altnifer/Crocoone/hardware/interface_board/Schematic_interface_board.pdf

Buttons | LCD ST7735S 1.8

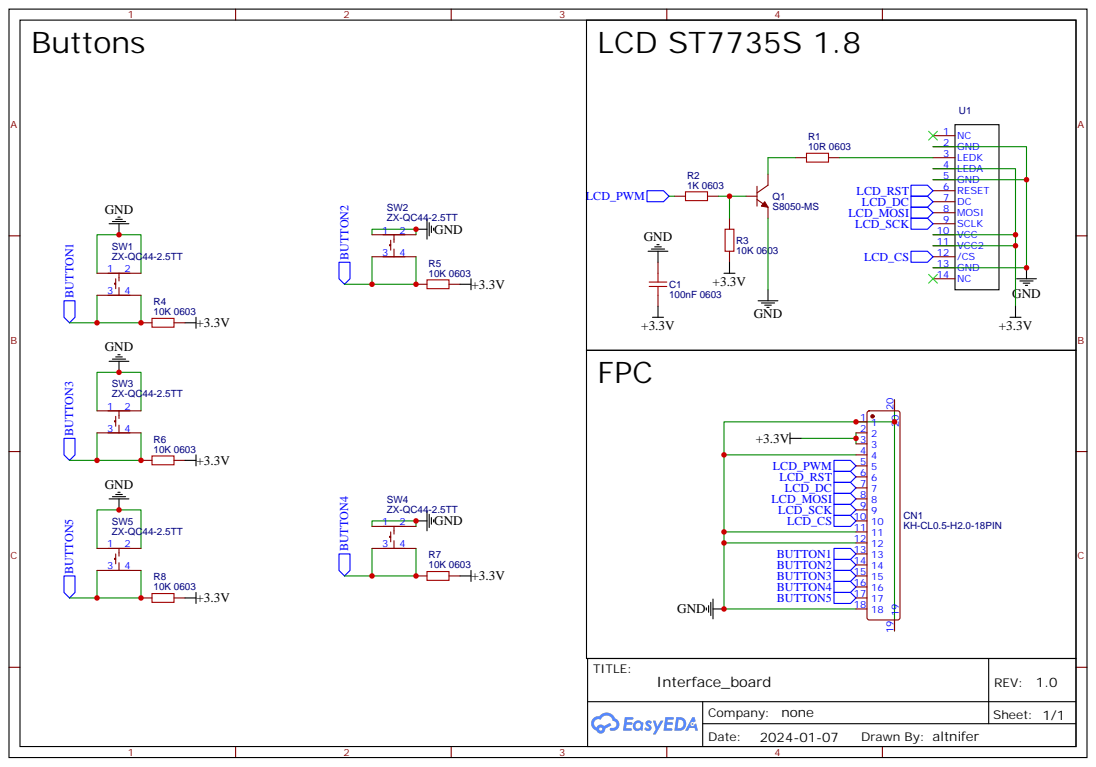
[picture p3: page 1]
