altnifer/Crocoone/hardware/main_board/Schematic_main_board.pdf

# User interface

# Core STM32H750

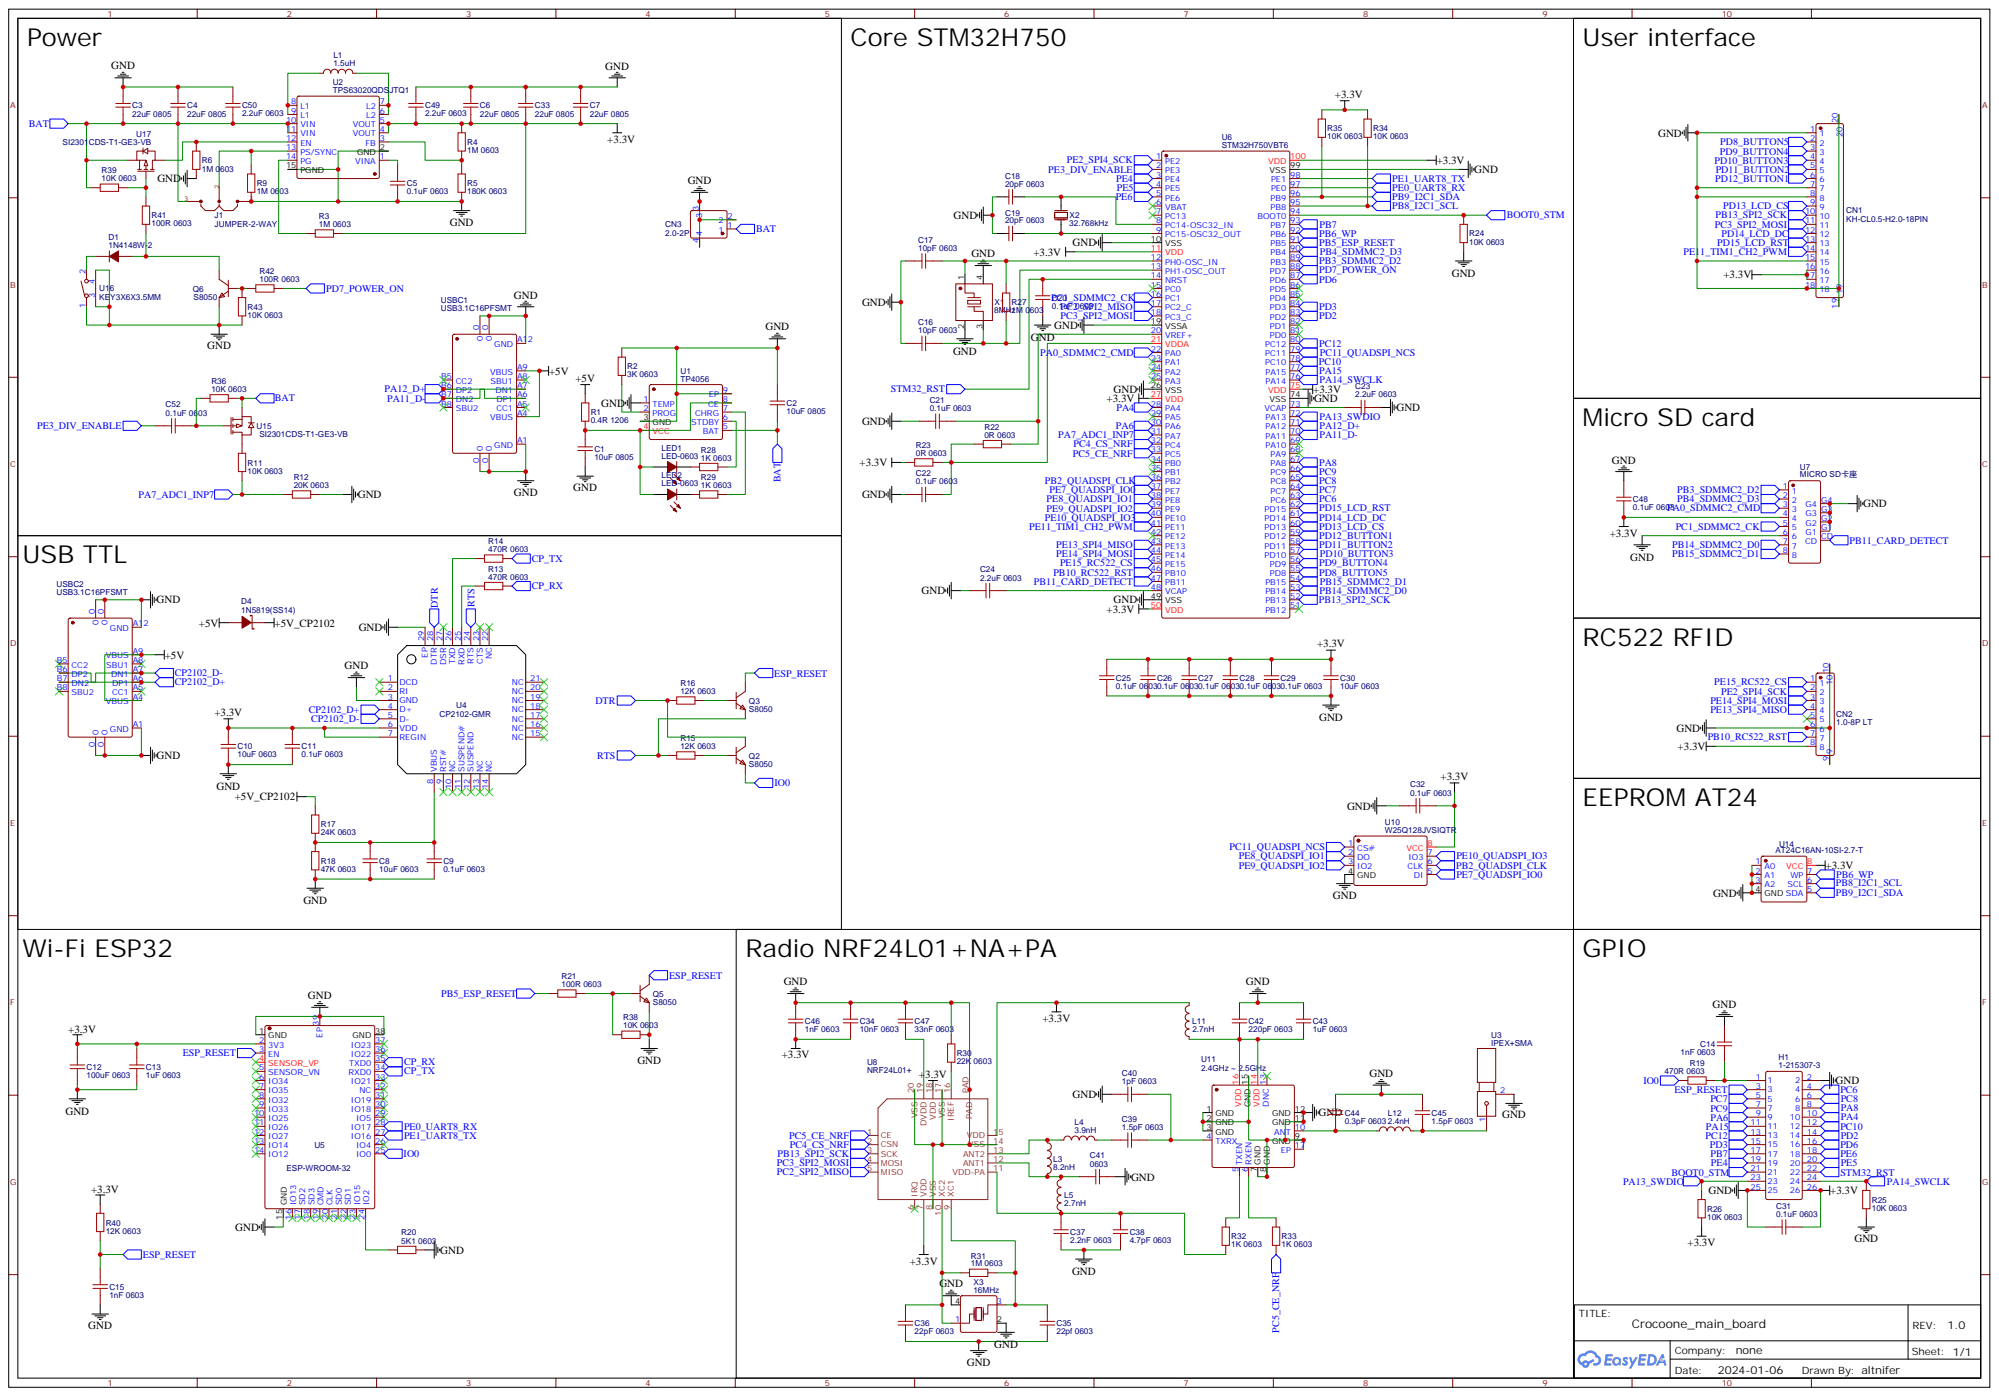
[picture p4: page 1]

NC 22 CTS 23 RTS 24 RXD 25 TXD 26 DSR 27 DTR 28 EP 29

IREF 16 VSS 17 VDD 18 DVDD 19 VSS 20
