altnifer/Crocoone/(list of files, drawings)

Other design files:
hardware/interface_board/PCB_interface_board.json
hardware/interface_board/SCH_interface_board.json
hardware/main_board/PCB_main_board.json
hardware/main_board/SCH_main_board.json
