altnifer/Crocoone/software/STM32/CROCOONE_H743_BOARD/Core/Src/main.c

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
/* Includes ------------------------------------------------------------------*/
#include "main.h"
#include "cmsis_os.h"
#include "fatfs.h"
#include "usb_device.h"

/* USER CODE BEGIN Includes */
#include <stdbool.h>
#include <string.h>

#include "semphr.h"

#include "SETTINGS.h"
#include "GFX_FUNCTIONS.h"
#include "title.h"
#include "button.h"
#include "flash_controller.h"
#include "uart_controller.h"
#include "packet_monitor.h"
#include "ch_analyzer.h"
#include "PMKID_attack.h"
#include "wifi_scan.h"
#include "deauth_attack.h"
#include "beacon_attack.h"
#include "handshake_attack.h"
#include "bad_usb_attack.h"
/* USER CODE END Includes */

/* USER CODE BEGIN PTD */
static const char *MAIN_MENU_SETS[] = {
	"Wi-Fi scan",
	"Ch Analyzer",
	"Pkt Analyzer",
	"PMKID attack",
	"deauth",
	"beacon",
	"handshake",
	"bad usb"
};
#define MAX_MAIN_MENU_SET_COUNT (sizeof(MAIN_MENU_SETS) / sizeof(char *))

SemaphoreHandle_t SPI2_mutex;
/* USER CODE END PTD */

ADC_HandleTypeDef hadc1;

QSPI_HandleTypeDef hqspi;

SD_HandleTypeDef hsd2;

SPI_HandleTypeDef hspi2;

TIM_HandleTypeDef htim1;
TIM_HandleTypeDef htim2;

UART_HandleTypeDef huart7;
UART_HandleTypeDef huart8;
DMA_HandleTypeDef hdma_uart8_rx;

/* Definitions for defaultTask */
osThreadId_t defaultTaskHandle;
const osThreadAttr_t defaultTask_attributes = {
  .name = "defaultTask",
  .stack_size = 1024 * 4,
  .priority = (osPriority_t) osPriorityNormal,
};
void SystemClock_Config(void);
static void MX_GPIO_Init(void);
static void MX_DMA_Init(void);
static void MX_SDMMC2_SD_Init(void);
static void MX_SPI2_Init(void);
static void MX_UART7_Init(void);
static void MX_UART8_Init(void);
static void MX_TIM1_Init(void);
static void MX_TIM2_Init(void);
static void MX_ADC1_Init(void);
static void MX_QUADSPI_Init(void);
void StartDefaultTask(void *argument);

/**
  * @brief  The application entry point.
  * @retval int
  */
int main(void)
{
  /* MCU Configuration--------------------------------------------------------*/

  /* Reset of all peripherals, Initializes the Flash interface and the Systick. */
  HAL_Init();

  /* Configure the system clock */
  SystemClock_Config();

  /* Initialize all configured peripherals */
  MX_GPIO_Init();
  MX_DMA_Init();
  MX_SDMMC2_SD_Init();
  MX_SPI2_Init();
  MX_UART7_Init();
  MX_UART8_Init();
  MX_TIM1_Init();
  MX_TIM2_Init();
  MX_ADC1_Init();
  MX_FATFS_Init();
  MX_QUADSPI_Init();
  /* USER CODE BEGIN 2 */
  HAL_GPIO_WritePin(POWER_ON_GPIO_Port, POWER_ON_Pin, GPIO_PIN_SET); //power on
  HAL_Delay(50);

  HAL_GPIO_WritePin(LCD_LIGHT_GPIO_Port, LCD_LIGHT_Pin, GPIO_PIN_RESET);
  ST7735_Init(0);
  fillScreen(MAIN_BG_COLOR);
  HAL_GPIO_WritePin(ESP_RESET_GPIO_Port, ESP_RESET_Pin, GPIO_PIN_SET);
  HAL_Delay(100);
  HAL_GPIO_WritePin(ESP_RESET_GPIO_Port, ESP_RESET_Pin, GPIO_PIN_RESET);
  HAL_GPIO_WritePin(LCD_LIGHT_GPIO_Port, LCD_LIGHT_Pin, GPIO_PIN_SET);

  ButtonsInit(5);
  AddButton(BUTTON_UP, BUTTON4_GPIO_Port, BUTTON4_Pin);
  AddButton(BUTTON_RIGHT, BUTTON1_GPIO_Port, BUTTON1_Pin);
  AddButton(BUTTON_CONFIRM, BUTTON3_GPIO_Port, BUTTON3_Pin);
  AddButton(BUTTON_LEFT, BUTTON5_GPIO_Port, BUTTON5_Pin);
  AddButton(BUTTON_DOWN, BUTTON2_GPIO_Port, BUTTON2_Pin);
  HAL_TIM_Base_Start_IT(&htim2);

  flash_init();
  nrf_init();
  powerDown();
  /* USER CODE END 2 */

  /* Init scheduler */
  osKernelInitialize();

  /* USER CODE BEGIN RTOS_MUTEX */
  /* add mutexes, ... */
  SPI2_mutex = xSemaphoreCreateMutex();
  /* USER CODE END RTOS_MUTEX */

  /* USER CODE BEGIN RTOS_SEMAPHORES */
  /* add semaphores, ... */
  /* USER CODE END RTOS_SEMAPHORES */

  /* USER CODE BEGIN RTOS_TIMERS */
  /* start timers, add new ones, ... */
  /* USER CODE END RTOS_TIMERS */

  /* USER CODE BEGIN RTOS_QUEUES */
  /* add queues, ... */
  /* USER CODE END RTOS_QUEUES */

  /* Create the thread(s) */
  /* creation of defaultTask */
  defaultTaskHandle = osThreadNew(StartDefaultTask, NULL, &defaultTask_attributes);

  /* USER CODE BEGIN RTOS_THREADS */
  /* add threads, ... */
  start_title_updater(&SPI2_mutex);
  /* USER CODE END RTOS_THREADS */

  /* USER CODE BEGIN RTOS_EVENTS */
  /* add events, ... */
  UART_parser_init();
  /* USER CODE END RTOS_EVENTS */

  /* Start scheduler */
  osKernelStart();

  /* We should never get here as control is now taken by the scheduler */
  /* Infinite loop */
  /* USER CODE BEGIN WHILE */
  while (1)
  {
	  break;
    /* USER CODE END WHILE */

    /* USER CODE BEGIN 3 */
  }

  return 0;
  /* USER CODE END 3 */
}

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
/* USER CODE BEGIN 4 */
void draw_main_menu(int curr_set, bool button, bool full_refresh) {
	static const uint16_t YStart = TITLE_END_Y + 9;
	static uint8_t prev_curr_set = 0;
	static bool prev_button = false;

	if (full_refresh) {
		refresh_title();
		fillScreenExceptTitle();
	}

	if (full_refresh || prev_curr_set != curr_set || prev_button != button) {
		drawMenu(
				(char **)MAIN_MENU_SETS,
				MAX_MAIN_MENU_SET_COUNT,
				12, YStart + 20, 116, YStart + 108,
				button ? -1 : curr_set,
				Font_7x10,
				MAIN_TXT_COLOR, MAIN_BG_COLOR
		);

	}

	if (full_refresh || prev_button != button) {
		drawIcon("functions", !button, 4, YStart, 125, YStart + 110, Font_7x10, MAIN_TXT_COLOR, MAIN_BG_COLOR);
		darwMiddleButton("power off", YStart + 120, Font_7x10, button, MAIN_TXT_COLOR, MAIN_BG_COLOR);
	}

	prev_curr_set = curr_set;
	prev_button = button;
}
/* USER CODE END 4 */

/* USER CODE BEGIN Header_StartDefaultTask */
/**
  * @brief  Function implementing the defaultTask thread.
  * @param  argument: Not used
  * @retval None
  */
/* USER CODE END Header_StartDefaultTask */
void StartDefaultTask(void *argument)
{
  /* USER CODE BEGIN 5 */
  static int curr_set = 0;
  static bool screen_update = true;
  static eButtonEvent button_up, button_down, button_confirm;
  static bool button = false;
  /* Infinite loop */
  while (1) {
	xSemaphoreTake(SPI2_mutex, portMAX_DELAY);
	if (screen_update) update_title_text("main menu");
	draw_main_menu(curr_set, button, screen_update);
	screen_update = false;
	xSemaphoreGive(SPI2_mutex);


	button_up = GetButtonState(BUTTON_UP);
	button_down = GetButtonState(BUTTON_DOWN);
	button_confirm = GetButtonState(BUTTON_CONFIRM);

	if (button_down == SINGLE_CLICK || button_down == HOLD) {
		curr_set = (curr_set + 1) % (int)MAX_MAIN_MENU_SET_COUNT;
	}
	if (button_up == SINGLE_CLICK || button_up == HOLD) {
		curr_set = (curr_set - 1) % (int)MAX_MAIN_MENU_SET_COUNT;
		if (curr_set < 0) curr_set = (int)MAX_MAIN_MENU_SET_COUNT - 1;
	}
	if (button_down == DOUBLE_CLICK || button_up == DOUBLE_CLICK)
		button = !button;
	if (button_confirm == SINGLE_CLICK && button) {
		HAL_GPIO_WritePin(LCD_LIGHT_GPIO_Port, LCD_LIGHT_Pin, GPIO_PIN_RESET);
	  	HAL_GPIO_WritePin(POWER_ON_GPIO_Port, POWER_ON_Pin, GPIO_PIN_RESET); //power off
		break;
	}
	if (button_confirm == SINGLE_CLICK) {
		if (curr_set == 0)
			ESP32_scan_wifi((TaskHandle_t *)&defaultTaskHandle);
		else if (curr_set == 1)
			NRF24_ch_analyzer((TaskHandle_t *)&defaultTaskHandle);
		else if (curr_set == 2)
			ESP32_start_packet_monitor((TaskHandle_t *)&defaultTaskHandle);
		else if (curr_set == 3)
			ESP32_start_pmkid_attack((TaskHandle_t *)&defaultTaskHandle);
		else if (curr_set == 4)
			ESP32_start_deauth_attack((TaskHandle_t *)&defaultTaskHandle);
		else if (curr_set == 5)
			ESP32_start_beacon_attack((TaskHandle_t *)&defaultTaskHandle);
		else if (curr_set == 6)
			ESP32_start_handshake_attack((TaskHandle_t *)&defaultTaskHandle);
		else if (curr_set == 7)
			USB_attack_start((TaskHandle_t *)&defaultTaskHandle);

		vTaskSuspend(NULL);

		ClearAllButtons();
		screen_update = true;
	}
    osDelay(250);
  }
  vTaskDelete(NULL);
  /* USER CODE END 5 */
}

/**
  * @brief  Period elapsed callback in non blocking mode
  * @note   This function is called  when TIM17 interrupt took place, inside
  * HAL_TIM_IRQHandler(). It makes a direct call to HAL_IncTick() to increment
  * a global variable "uwTick" used as application time base.
  * @param  htim : TIM handle
  * @retval None
  */
void HAL_TIM_PeriodElapsedCallback(TIM_HandleTypeDef *htim)
{
  if (htim->Instance == TIM17) {
    HAL_IncTick();
  }
  /* USER CODE BEGIN Callback 1 */
  if(htim->Instance == TIM2) {
	  button_update();
  }
  /* USER CODE END Callback 1 */
}

/**
  * @brief  This function is executed in case of error occurrence.
  * @retval None
  */
void Error_Handler(void)
{
  /* USER CODE BEGIN Error_Handler_Debug */
  /* User can add his own implementation to report the HAL error return state */
  __disable_irq();
  while (1)
  {
  }
  /* USER CODE END Error_Handler_Debug */
}

#ifdef  USE_FULL_ASSERT
/**
  * @brief  Reports the name of the source file and the source line number
  *         where the assert_param error has occurred.
  * @param  file: pointer to the source file name
  * @param  line: assert_param error line source number
  * @retval None
  */
void assert_failed(uint8_t *file, uint32_t line)
{
  /* USER CODE BEGIN 6 */
  /* User can add his own implementation to report the file name and line number,
     ex: printf("Wrong parameters value: file %s on line %d\r\n", file, line) */
  /* USER CODE END 6 */
}
#endif /* USE_FULL_ASSERT */
