altnifer/Crocoone/software/STM32/CROCOONE_H743_BOARD/CROCOONE_H743_BOARD.ioc

Mcu.UserName=STM32H743VITx
PA0.Signal=SDMMC2_CMD
PA11.Signal=USB_OTG_FS_DM
PA12.Signal=USB_OTG_FS_DP
PA7.Signal=ADCx_INP7
PA8.Signal=UART7_RX
PB11.GPIO_Label=CARD_DETECT
PB11.Signal=GPIO_Input
PB13.Signal=SPI2_SCK
PB14.Signal=SDMMC2_D0
PB15.Signal=SDMMC2_D1
PB2.Signal=QUADSPI_CLK
PB5.GPIO_Label=ESP_RESET
PB5.Signal=GPIO_Output
PB6.GPIO_Label=AT24CXX_WP
PB6.Signal=GPIO_Output
PC1.Signal=SDMMC2_CK
PC11.Signal=QUADSPI_BK2_NCS
PC2_C.Signal=SPI2_MISO
PC3_C.Signal=SPI2_MOSI
PC4.GPIO_Label=CS_NRF
PC4.Signal=GPIO_Output
PC5.GPIO_Label=CE_NRF
PC5.Signal=GPIO_Output
PD10.GPIO_Label=BUTTON3
PD10.Signal=GPXTI10
PD11.GPIO_Label=BUTTON2
PD11.Signal=GPXTI11
PD12.GPIO_Label=BUTTON1
PD12.Signal=GPXTI12
PD13.GPIO_Label=LCD_CS
PD13.Signal=GPIO_Output
PD14.GPIO_Label=LCD_DC
PD14.Signal=GPIO_Output
PD15.GPIO_Label=LCD_RST
PD15.Signal=GPIO_Output
PD7.GPIO_Label=POWER_ON
PD7.Signal=GPIO_Output
PD8.GPIO_Label=BUTTON5
PD8.Signal=GPXTI8
PD9.GPIO_Label=BUTTON4
PD9.Signal=GPXTI9
PE0.Signal=UART8_RX
PE1.Signal=UART8_TX
PE10.Signal=QUADSPI_BK2_IO3
PE11.GPIO_Label=LCD_LIGHT
PE11.Signal=GPIO_Output
PE3.GPIO_Label=DIV_ENABLE
PE3.Signal=GPIO_Output
PE7.Signal=QUADSPI_BK2_IO0
PE8.Signal=QUADSPI_BK2_IO1
PE9.Signal=QUADSPI_BK2_IO2
