altnifer/Crocoone/software/STM32/CROCOONE_H743_BOARD/ESP32_controller/uart_controller.c

/*
 * uart_parser.c
 *
 *  Created on: May 22, 2024
 *      Author: nikit
 */
#include <uart_controller.h>
#include "cmsis_os.h"
#include "semphr.h"
#include <string.h>
#include <stdio.h>

static SemaphoreHandle_t IDLE_semaphore;
static SemaphoreHandle_t UART_ringBuffer_mutex;
static SemaphoreHandle_t ESP_UART_mutex;
static BaseType_t xHigherPriorityTaskWoken = pdFALSE;
static ring_buffer_t ring_buffer;
static uint8_t rx_buff[RX_BUFF_SIZE] = {};
static uint8_t tx_buff[TX_BUFF_SIZE] = {};
static uint16_t pkts_recieved = 0;
static uint16_t last_pkt_size = 0;
static uint32_t last_send_time_ms = 0;

uint16_t add_cmd_to_buff(cmd_data_t cmd_data, char *buff);
void IDLE_ISR_handler_task(void * args);

void HAL_UARTEx_RxEventCallback(UART_HandleTypeDef *huart, uint16_t Size)
{
	if (huart == &ESP32_AT_UART_Port)
	{
		last_pkt_size = Size;
		xHigherPriorityTaskWoken = pdFALSE;
		xSemaphoreGiveFromISR(IDLE_semaphore, &xHigherPriorityTaskWoken);
		portYIELD_FROM_ISR(xHigherPriorityTaskWoken);
	}
}

void IDLE_ISR_handler_task(void * args) {
	HAL_UARTEx_ReceiveToIdle_DMA(&ESP32_AT_UART_Port, rx_buff, RX_BUFF_SIZE);
	__HAL_DMA_DISABLE_IT(&ESP32_UART_DMA_LINE, DMA_IT_HT);

	while (1) {
		xSemaphoreTake(IDLE_semaphore, portMAX_DELAY);

		xSemaphoreTake(UART_ringBuffer_mutex, portMAX_DELAY);
		if (ringBuffer_add(&ring_buffer, rx_buff, last_pkt_size)) {
			last_pkt_size = 0;
			pkts_recieved++;
		}
		xSemaphoreGive(UART_ringBuffer_mutex);

		xSemaphoreTake(ESP_UART_mutex, portMAX_DELAY);
		HAL_UARTEx_ReceiveToIdle_DMA(&ESP32_AT_UART_Port, rx_buff, RX_BUFF_SIZE);
		__HAL_DMA_DISABLE_IT(&ESP32_UART_DMA_LINE, DMA_IT_HT);
		xSemaphoreGive(ESP_UART_mutex);

		osDelay(1);
	}

	vTaskDelete(NULL);
}

void UART_ringBuffer_mutex_take() {
	xSemaphoreTake(UART_ringBuffer_mutex, portMAX_DELAY);
}

void UART_ringBuffer_mutex_give() {
	xSemaphoreGive(UART_ringBuffer_mutex);
}

void UART_parser_init() {
	ringBuffer_init(&ring_buffer, 13);
	IDLE_semaphore = xSemaphoreCreateBinary();
	UART_ringBuffer_mutex = xSemaphoreCreateMutex();
	ESP_UART_mutex = xSemaphoreCreateMutex();
	xTaskCreate(IDLE_ISR_handler_task, "IDLE_handler", 1024 * 4, NULL, osPriorityRealtime, NULL);
}

ring_buffer_t *get_ring_buff() {
	return &ring_buffer;
}

uint16_t get_recieved_pkts_count() {
	uint16_t ret_val = pkts_recieved;
	pkts_recieved = 0;
	return ret_val;
}

bool send_cmd_with_check(cmd_data_t cmd_data, char *error_buff, uint32_t timeout_ms) {
	bool ret_val = false;

	uint32_t timeout_between_last_send = HAL_GetTick() - last_send_time_ms;
	if (timeout_between_last_send < MIN_TIMEOUT_BETWEEN_SEND_MS)
		vTaskDelay(timeout_between_last_send / portTICK_PERIOD_MS);

	xSemaphoreTake(UART_ringBuffer_mutex, portMAX_DELAY);
	ringBuffer_clear(&ring_buffer);

	pkts_recieved = 0;
	uint16_t cmd_len = add_cmd_to_buff(cmd_data, (char *)(tx_buff));
	memcpy(error_buff, (char *)(tx_buff), cmd_len);
	memcpy(error_buff + cmd_len, " ", 2);

	xSemaphoreTake(ESP_UART_mutex, portMAX_DELAY);
	HAL_UART_Transmit(&ESP32_AT_UART_Port, tx_buff, cmd_len, 100);
	HAL_UARTEx_ReceiveToIdle_DMA(&ESP32_AT_UART_Port, rx_buff, RX_BUFF_SIZE);
	__HAL_DMA_DISABLE_IT(&ESP32_UART_DMA_LINE, DMA_IT_HT);
	xSemaphoreGive(ESP_UART_mutex);

	xSemaphoreGive(UART_ringBuffer_mutex);

	int32_t msg_start;
	uint32_t curr_time = HAL_GetTick();
	while ((HAL_GetTick() - curr_time) < timeout_ms) {
		if (!pkts_recieved) continue;
		pkts_recieved = 0;
		xSemaphoreTake(UART_ringBuffer_mutex, portMAX_DELAY);
		if ((msg_start = ringBuffer_findSequence(&ring_buffer, tx_buff, cmd_len)) == -1) {
			xSemaphoreGive(UART_ringBuffer_mutex);
			continue;
		}

		if (ringBuffer_findSequence(&ring_buffer,
				(uint8_t *)" - cmd accepted and started",
				strlen(" - cmd accepted and started")
		) != -1) {
			ret_val = true;
		}


		uint16_t error_responce_len = strlen(" - cmd accepted with error: ");
		if (ringBuffer_findSequence(&ring_buffer,
				(uint8_t *)" - cmd accepted with error: ",
				error_responce_len
		) != -1) {
			ringBuffer_clearNBytes(&ring_buffer, msg_start + cmd_len + error_responce_len);
			int32_t erro_msg_len = ringBuffer_findSequence(&ring_buffer, (uint8_t *)"\n", 1);
			ringBuffer_get(&ring_buffer, (uint8_t *)(error_buff + cmd_len + 1), erro_msg_len);
			error_buff[erro_msg_len + cmd_len + 1] = '\0';
			ret_val = false;
		}

		last_send_time_ms = HAL_GetTick();
		xSemaphoreGive(UART_ringBuffer_mutex);
		return ret_val;
	}

	memcpy(error_buff + cmd_len + 1, "no response", strlen("no response") + 1);
	return ret_val;
}

void send_cmd_without_check(cmd_data_t cmd_data) {
	uint32_t timeout_between_last_send = HAL_GetTick() - last_send_time_ms;
	if (timeout_between_last_send < MIN_TIMEOUT_BETWEEN_SEND_MS)
		vTaskDelay(timeout_between_last_send / portTICK_PERIOD_MS);

	uint16_t cmd_len = add_cmd_to_buff(cmd_data, (char *)tx_buff);

	xSemaphoreTake(ESP_UART_mutex, portMAX_DELAY);
	HAL_UART_Transmit(&ESP32_AT_UART_Port, tx_buff, cmd_len, 100);
	HAL_UARTEx_ReceiveToIdle_DMA(&ESP32_AT_UART_Port, rx_buff, RX_BUFF_SIZE);
	__HAL_DMA_DISABLE_IT(&ESP32_UART_DMA_LINE, DMA_IT_HT);
	xSemaphoreGive(ESP_UART_mutex);

	last_send_time_ms = HAL_GetTick();
}

uint16_t add_cmd_to_buff(cmd_data_t cmd_data, char *buff) {
    sprintf(buff, "%s%s%c", CMD_START, cmd_data.cmdName, CMD_PARAM_START);
    uint16_t buff_len = strlen(buff);
    for (int i = 0; i < MAX_PARAM_COUNT - 1; i++) {
        sprintf(buff + buff_len, "%d,", cmd_data.param[i]);
        buff_len = strlen(buff);
    }
    sprintf(buff + buff_len, "%d", cmd_data.param[MAX_PARAM_COUNT - 1]);

    return strlen(buff);
}
