altnifer/Crocoone/software/STM32/CROCOONE_H743_BOARD/Core/Inc/SETTINGS.h

#ifndef __SETTINGS__
#define __SETTINGS__

// color and graphic
#define	BLACK   0x0000
#define	BLUE    0x001F
#define	RED     0xF800
#define	GREEN   0x07E0
#define CYAN    0x07FF
#define MAGENTA 0xF81F
#define YELLOW  0xFFE0
#define WHITE   0xFFFF
#define ORANGE  0xFBE4

#define MAIN_TXT_COLOR WHITE//ORANGE
#define MAIN_BG_COLOR BLACK
#define MAIN_ERROR_COLOR RED
//

// buttons
#define BUTTON_UP 1
#define BUTTON_DOWN 5
#define BUTTON_LEFT 4
#define BUTTON_RIGHT 2
#define BUTTON_CONFIRM 3

#define HOLD_MENU_DELLAY 400
#define HOLD_FAST_DELLAY 100
//

#endif /* __TIM_H__ */
