altnifer/Crocoone/(commit log)

2024-07-09 deauthentication attack
    deauthentication attack and esp uart error handling
    [PMKID_attack.c, deauth_attack.c, deauth_attack.h, main.c, packet_monitor.c, tasks_mannager.c, uart_controller.c, uart_controller.h]
2024-07-12 handshake attack
    evil ap and combine methods do not work yet
    [attack_handshake.c, attack_handshake.h, attack_pmkid.c, attack_pmkid.h, data_converter.c, data_converter.h, deauth_attack.c, handshake_attack.c]
2024-07-28 NOR FLASH instead of EEPROM
    The EEPROM AT24Cxx is no longer used. Replaced by W25Qxx
    [CROCOONE_H743_BOARD.ioc, PMKID_attack.c, beacon_attack.c, deauth_attack.c, flash_controller.c, flash_controller.h, handshake_attack.c, main.c]
