altnifer/Crocoone/(notices)

Notices in the files:
software/STM32/CROCOONE_H743_BOARD/Core/Src/main.c:
Copyright (c) 2024 STMicroelectronics.
All rights reserved.
This software is licensed under terms that can be found in the LICENSE file
